robertofelix/atari-2600-av-bracket/1din5-1rca/exports/av_bracket_din5.step

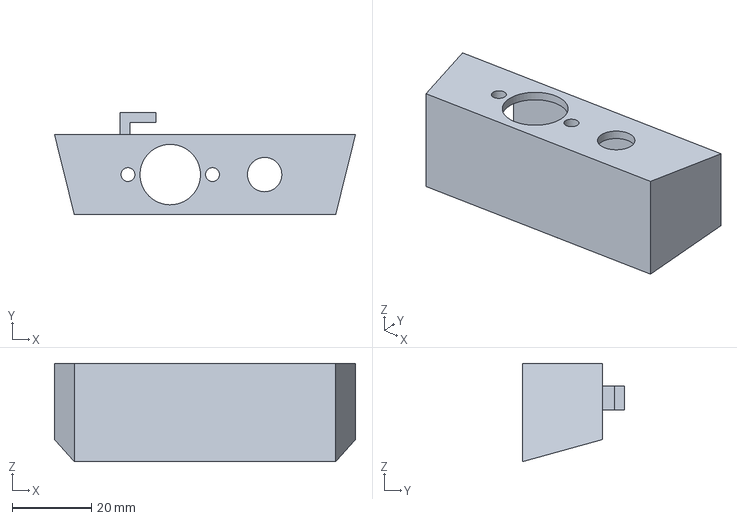
[picture p12: CAD file, 2026-11-13]
1din5-1rca/exports/av_bracket_din5.step
76.2 x 25.8 x 24.9 mm
