robertofelix/atari-2600-av-bracket/3-holes-recessed/exports/av_bracket_recessed_print.stl

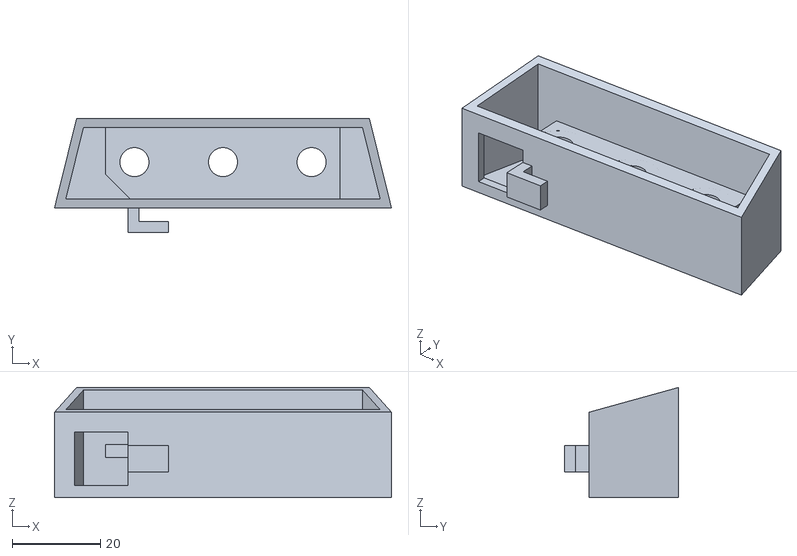
[picture p13: CAD file, 2026-11-13]
3-holes-recessed/exports/av_bracket_recessed_print.stl
76.2 x 25.8 x 24.9
