robertofelix/atari-2600-av-bracket/3rca-1svideo/exports/av_bracket_svideo.step

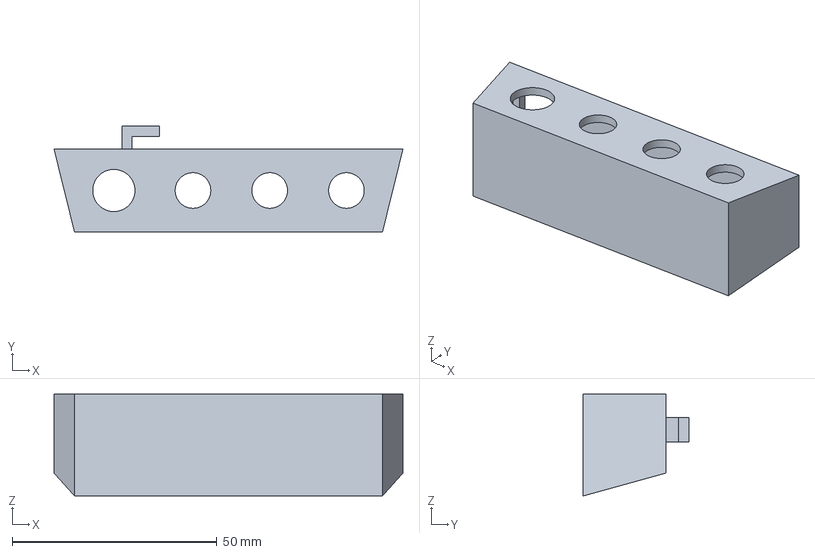
[picture p14: CAD file, 2026-11-13]
3rca-1svideo/exports/av_bracket_svideo.step
85.2 x 25.8 x 24.9 mm
