robertofelix/atari-2600-av-bracket/arch-plug/exports/av_arch_plug.step

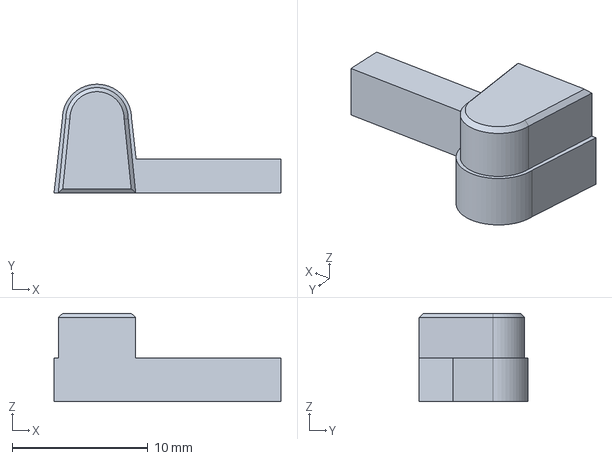
[picture p15: CAD file, 2026-10-31]
arch-plug/exports/av_arch_plug.step
16.7 x 8.00 x 6.50 mm
