robertofelix/atari-2600-av-bracket/(list of files, cad)

Other CAD files:
3-holes/exports/av_bracket_3h.step
4-holes/exports/av_bracket_4h.stl
exports/av_bracket_arch_plug.stl
3-holes-recessed/exports/av_bracket_recessed.step
3-holes/exports/av_bracket_3h_print.stl
3rca-1svideo/exports/av_bracket_svideo_print.stl
exports/av_bracket.step
exports/av_bracket_print.stl
1din5-1rca/exports/av_bracket_din5.stl
3-holes-recessed/exports/av_bracket_recessed.stl
3-holes/exports/av_bracket_3h.stl
3rca-1svideo/exports/av_bracket_svideo.stl
exports/av_bracket.stl
