robertofelix/atari-2600-av-bracket/(commit log)

2026-10-29 IA-001: Add temporary switch to disable the L tab for angle prototypePrototype: disable L tab to validate the back angle (#1)
    * Prototype: disable L tab to validate the back angle
    * Adjusting the L bracket
    * Prototype approved
    ---------
2026-10-31 Add 3-holes version
2026-11-09 Fix author of 3-holes-recessed
2026-11-13 Increase space between holes in the 4 holes versions (#2)
